MatthewBregg/S-Core-DC-Drive-Rival-Mag-Grip-SMG/Documentation/documentation_images/DSC06030.JPG

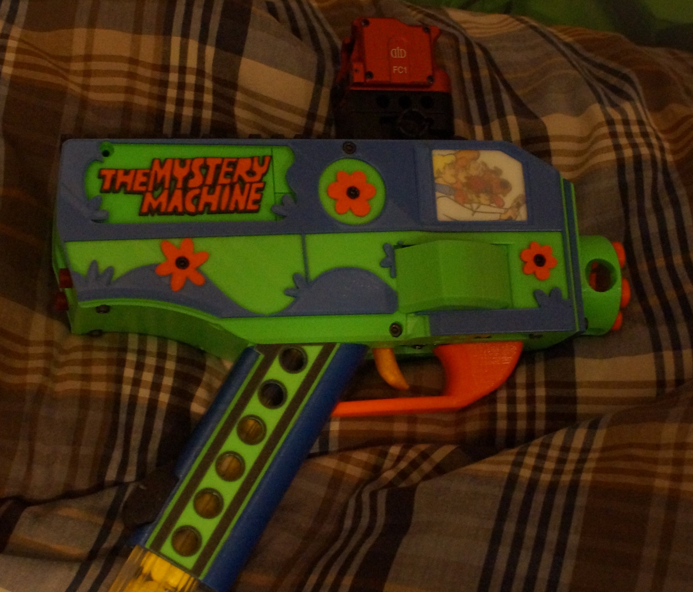
Documentation/documentation_images/DSC06030.JPG
