MatthewBregg/S-Core-DC-Drive-Rival-Mag-Grip-SMG/Documentation/documentation_images/lead.JPG

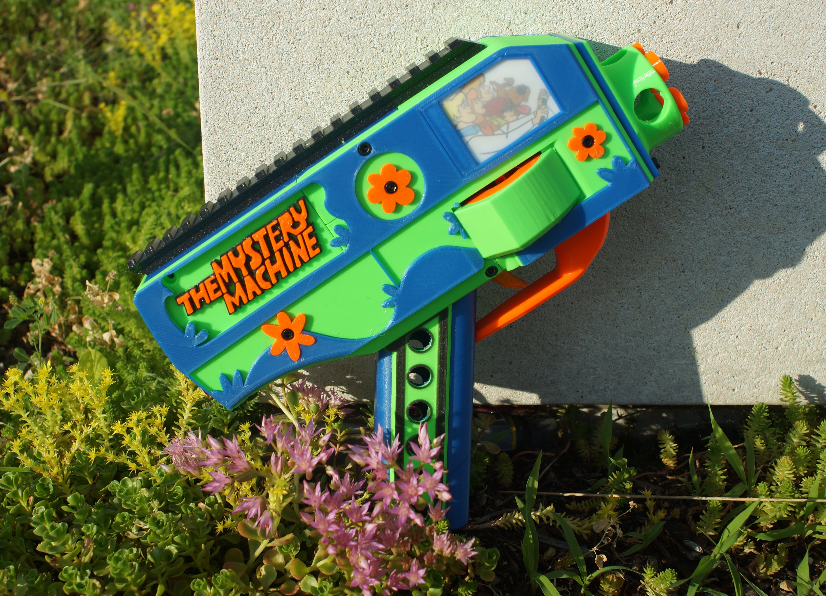
Documentation/documentation_images/lead.JPG
