MatthewBregg/S-Core-DC-Drive-Rival-Mag-Grip-SMG/Documentation/documentation_images/plated/grip_var_height.png

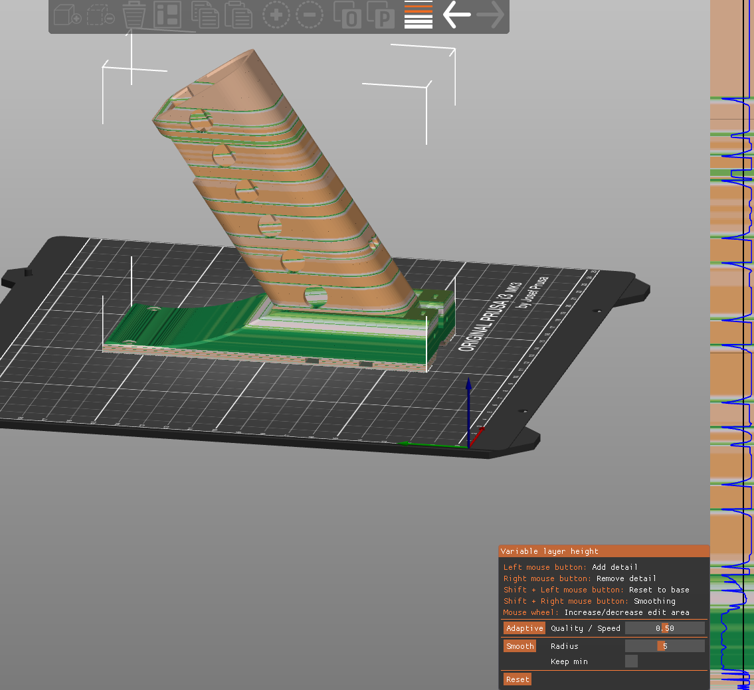
Documentation/documentation_images/plated/grip_var_height.png
