MatthewBregg/S-Core-DC-Drive-Rival-Mag-Grip-SMG/Documentation/documentation_images/plated/trigger_guard_with_supports.png

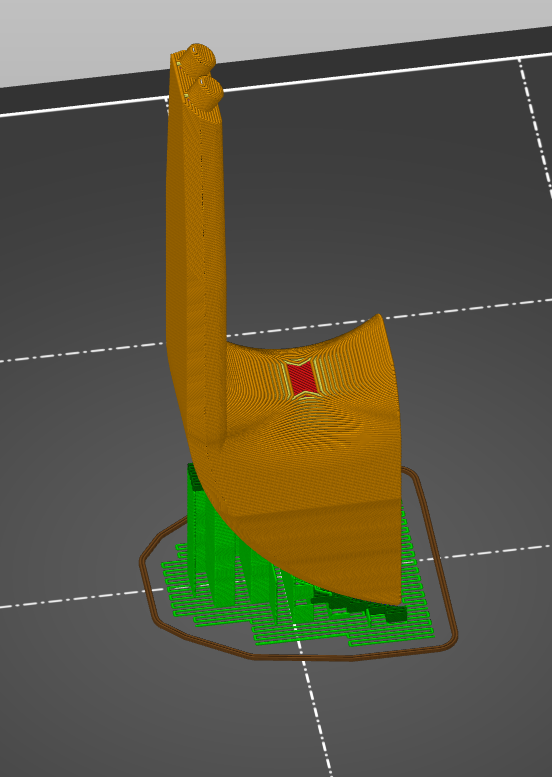
Documentation/documentation_images/plated/trigger_guard_with_supports.png
