MatthewBregg/S-Core-DC-Drive-Rival-Mag-Grip-SMG/Documentation/documentation_images/physical_build/used_images/2020-07-04 18.20.19.jpg

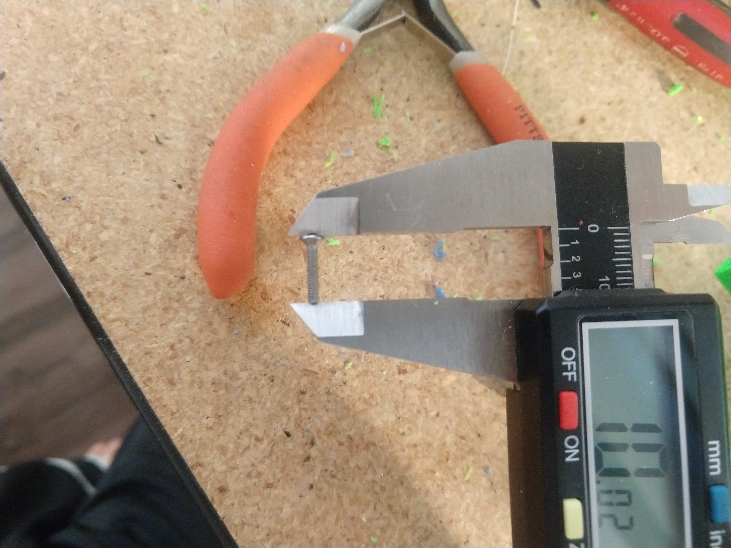
Documentation/documentation_images/physical_build/used_images/2020-07-04 18.20.19.jpg
