MatthewBregg/S-Core-DC-Drive-Rival-Mag-Grip-SMG/Documentation/documentation_images/physical_build/used_images/2020-07-05_15-42.png

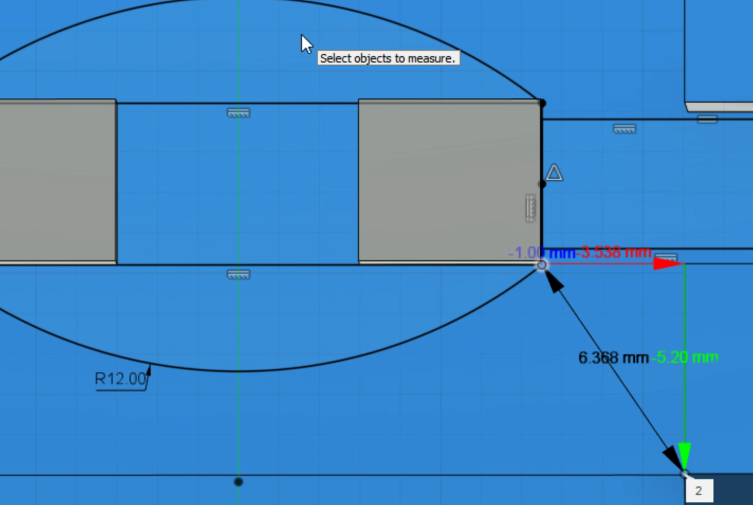
Documentation/documentation_images/physical_build/used_images/2020-07-05_15-42.png
