MatthewBregg/S-Core-DC-Drive-Rival-Mag-Grip-SMG/Documentation/documentation_images/physical_build/used_images/fwc_holes_1.jpg

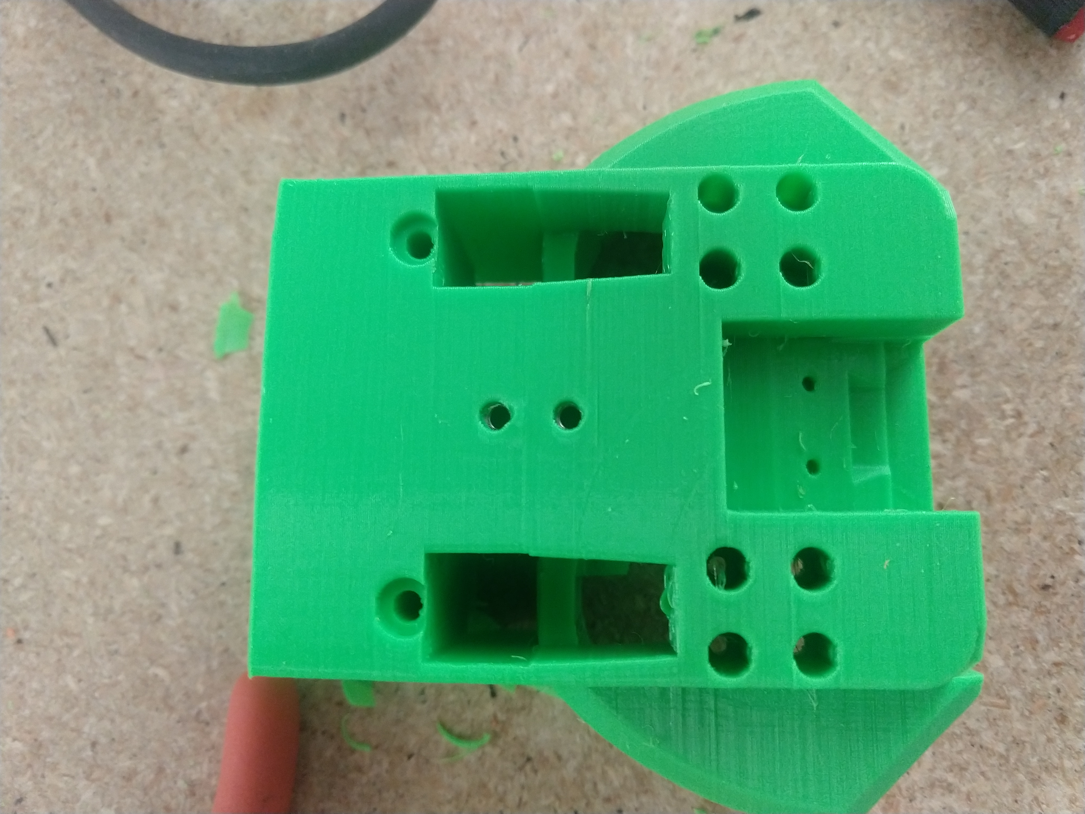
Documentation/documentation_images/physical_build/used_images/fwc_holes_1.jpg
