MatthewBregg/S-Core-DC-Drive-Rival-Mag-Grip-SMG/Documentation/documentation_images/physical_build/used_images/fwc_voer_nuts_b.png

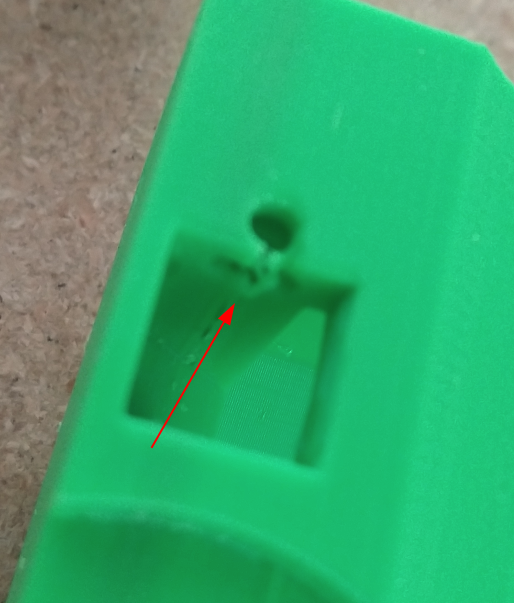
Documentation/documentation_images/physical_build/used_images/fwc_voer_nuts_b.png
