MatthewBregg/S-Core-DC-Drive-Rival-Mag-Grip-SMG/Documentation/documentation_images/physical_build/used_images/new_catch_side.jpg

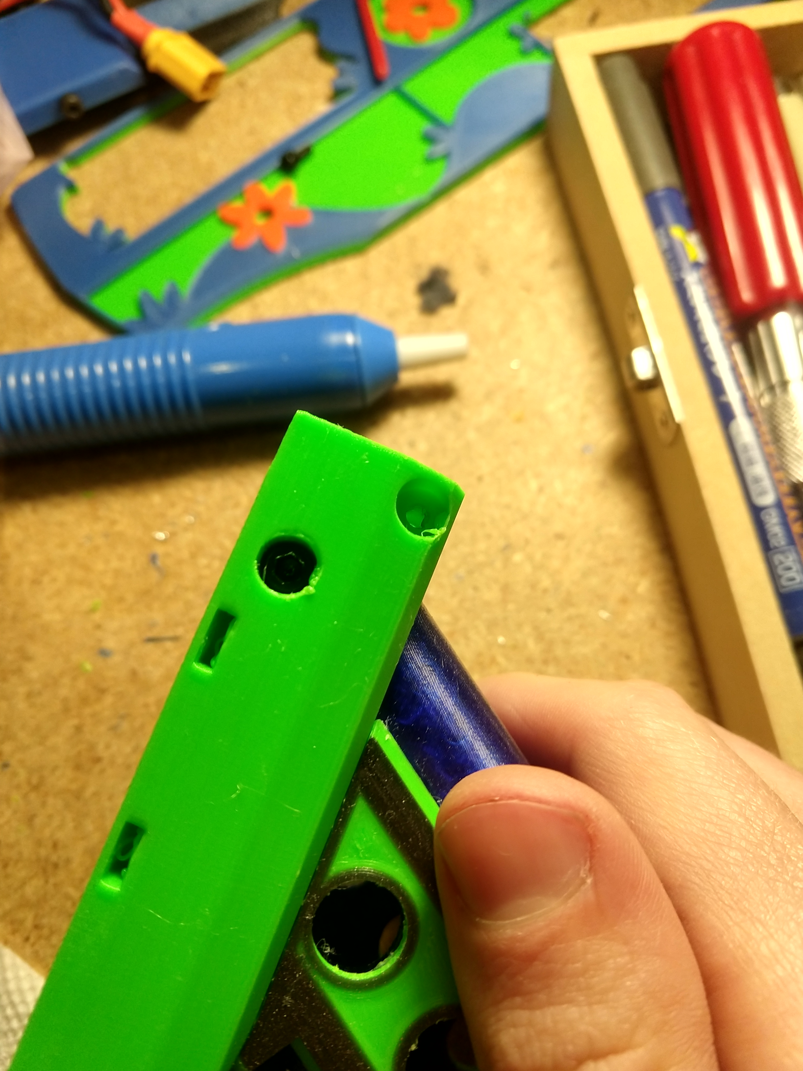
Documentation/documentation_images/physical_build/used_images/new_catch_side.jpg
