MatthewBregg/S-Core-DC-Drive-Rival-Mag-Grip-SMG/(commit log)

2020-06-15 Replace the stepper blipper with a led
    [S-Core.ino]
2020-06-15 Remove stepper firing code
2020-06-15 Anti stall code works!
    [S-Core.ino]
2020-07-06 Add CC license to cover STL files.
2020-07-06 fwc plate info
2021-06-28 Delay the overspeed check by 100 ms to avoid falsely triggering it during boot.
    [S-Core.ino]
