MatthewBregg/S-Core-DC-Drive-Rival-Mag-Grip-SMG/Documentation/documentation_images/physical_build/used_images/old_broken_catch.jpg

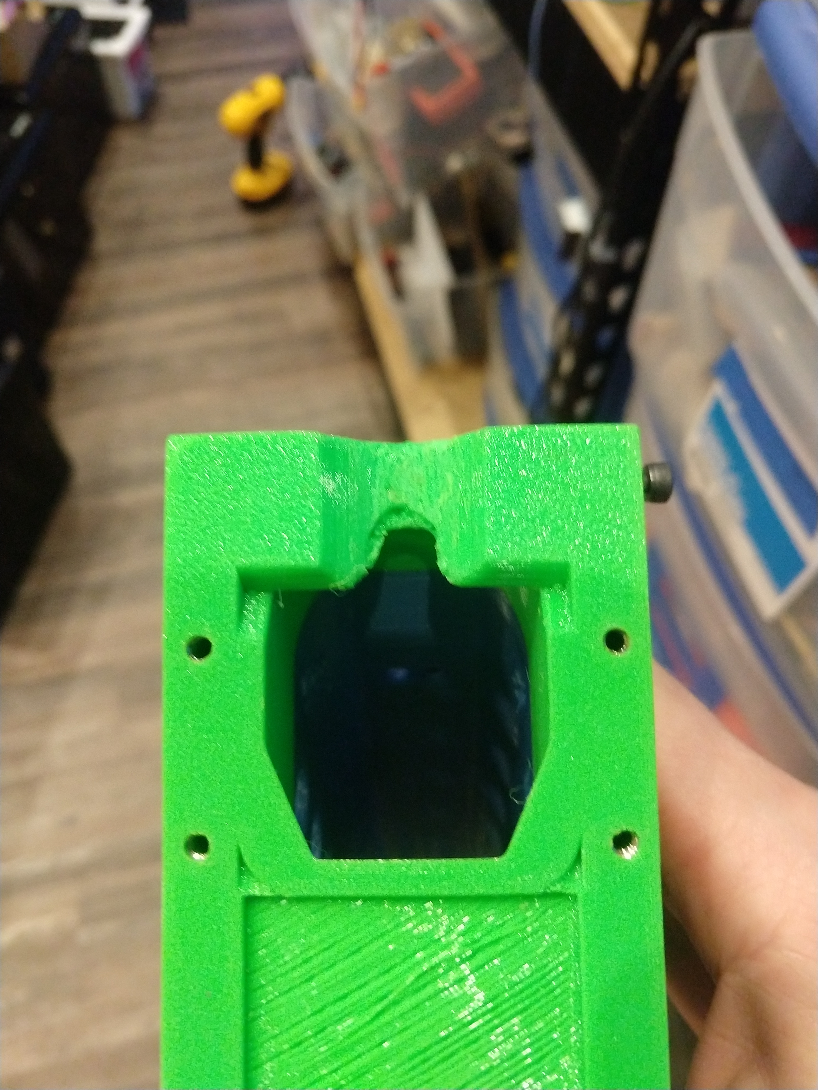
[picture p76: Documentation/documentation_images/physical_build/used_images/old_broken_catch.jpg]
Documentation/documentation_images/physical_build/used_images/old_broken_catch.jpg
